holmesrichards/8StepSequencer/Docs/lmnc_8_step_seq.pdf

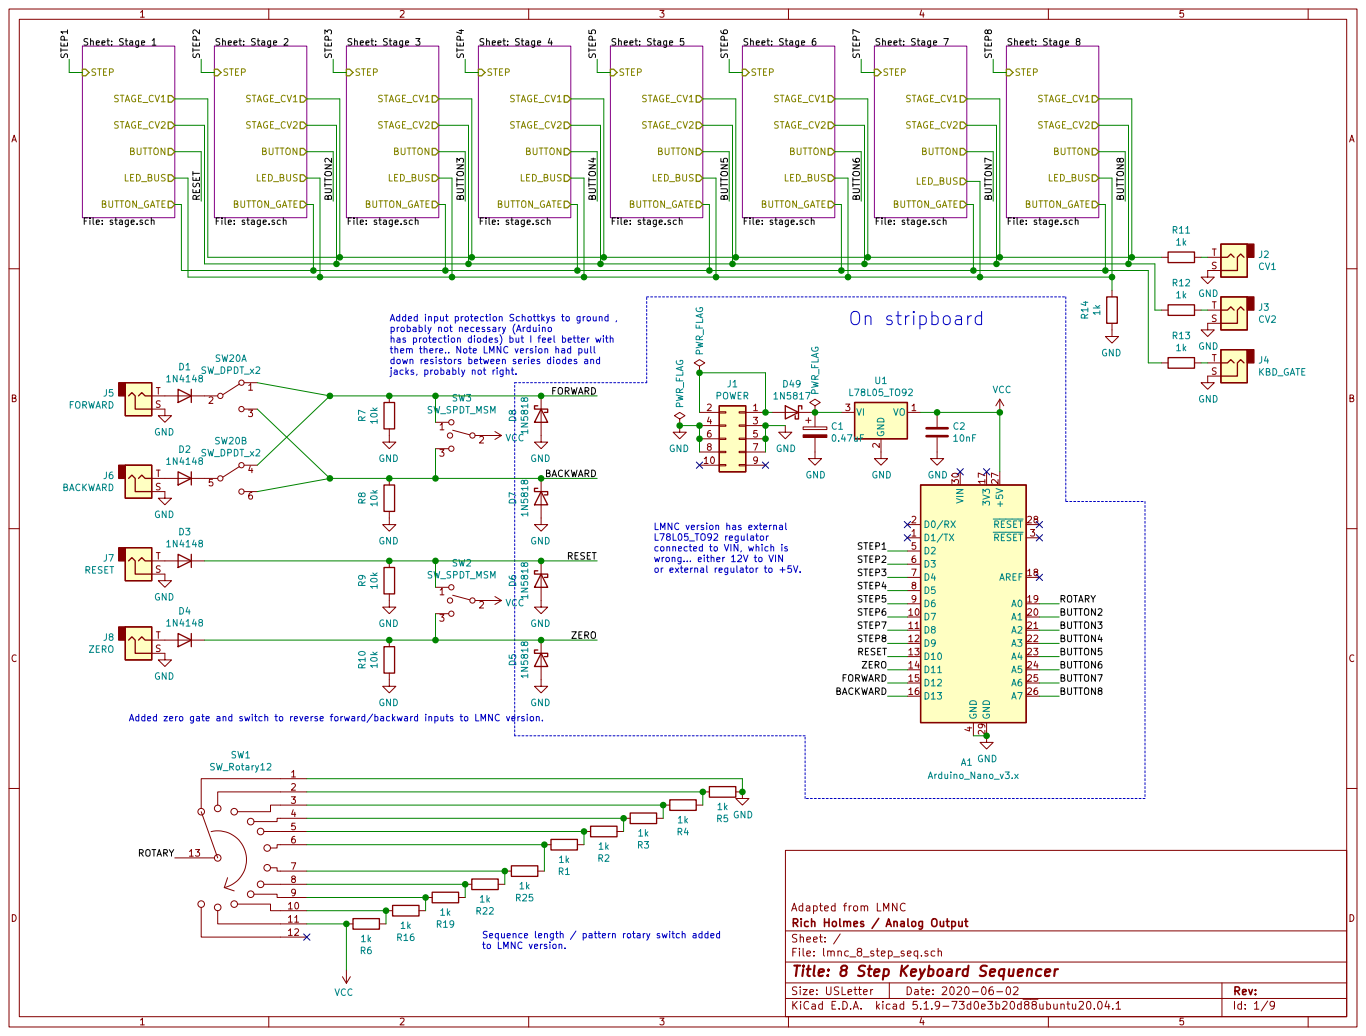
[picture p1: page 1]

File: stage.sch STAGE_CV1 STAGE_CV2 STEP

Added input protection Schottkys to ground ,
probably not necessary (Arduino
has protection diodes) but I feel better with
them there.. Note LMNC version had pull down resistors between series diodes and

jacks, probably not right.

GND GND

STEP8 STEP2 STEP7 STEP6 Sequence length / pattern rotary switch added

or external regulator to +5V.

Adapted from LMNC
File: lmnc_8_step_seq.sch Sheet: / Rich Holmes / Analog Output

Id: 1/9 Title: 8 Step Keyboard Sequencer

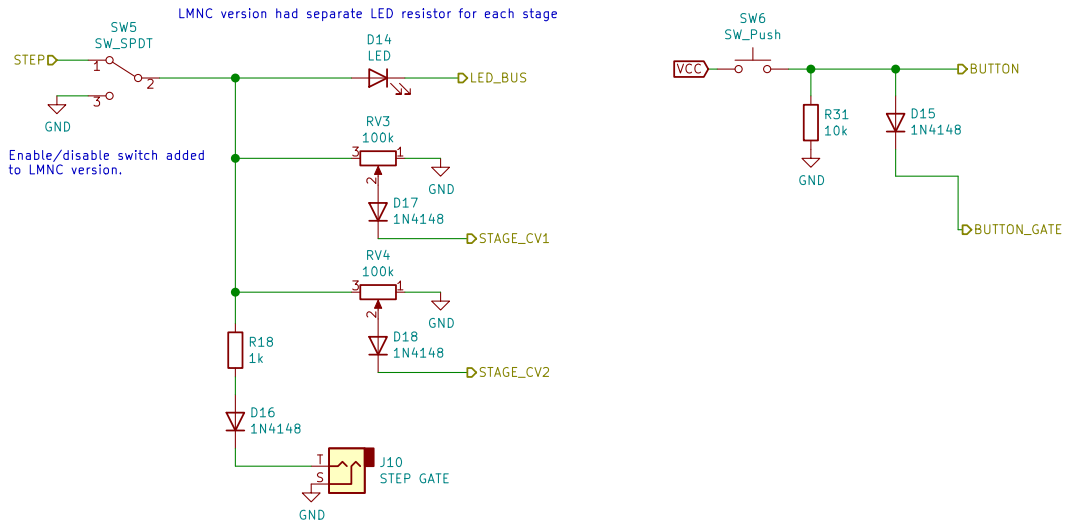
[picture p2: page 2]

LMNC version had separate LED resistor for each stage Enable/disable switch added

Adapted from LMNC
Rich Holmes / Analog Output
Sheet: /Stage 2/
File: stage.sch
Id: 2/9 Title: 8 Step Keyboard Sequencer

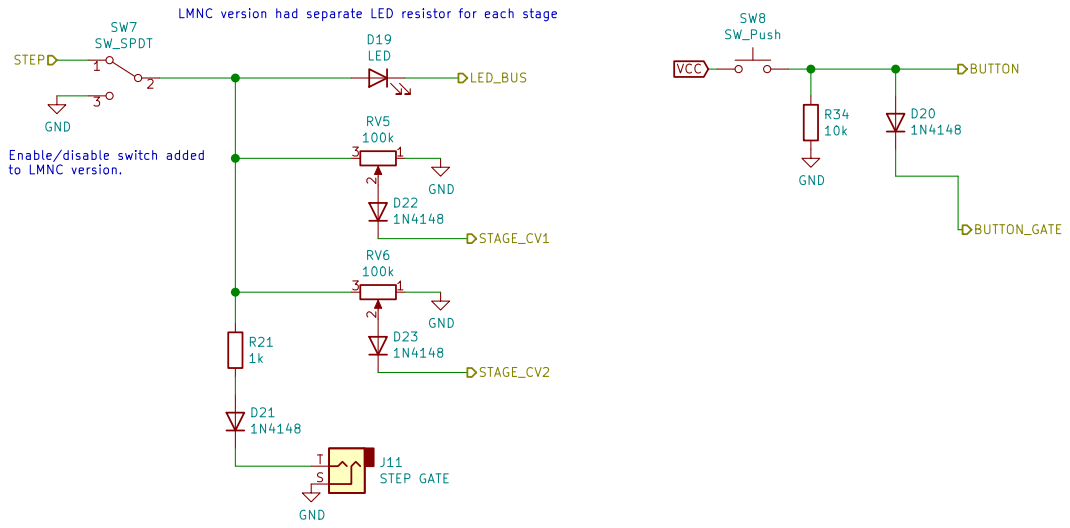
[picture p3: page 3]

LMNC version had separate LED resistor for each stage Enable/disable switch added

Adapted from LMNC
Rich Holmes / Analog Output
Sheet: /Stage 3/
File: stage.sch
Id: 3/9 Title: 8 Step Keyboard Sequencer

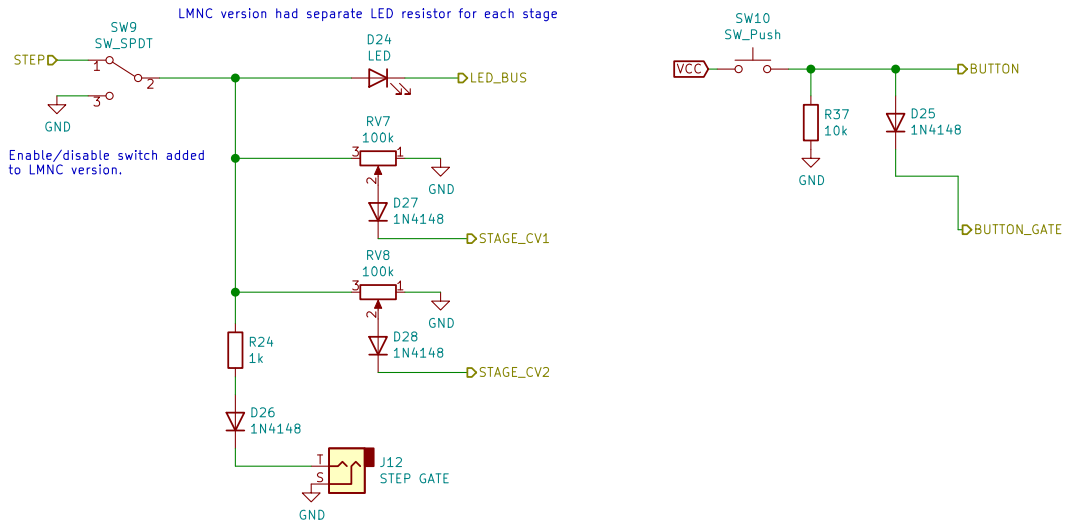
[picture p4: page 4]

LMNC version had separate LED resistor for each stage Enable/disable switch added

Adapted from LMNC
Rich Holmes / Analog Output
Sheet: /Stage 8/
File: stage.sch
Id: 4/9 Title: 8 Step Keyboard Sequencer

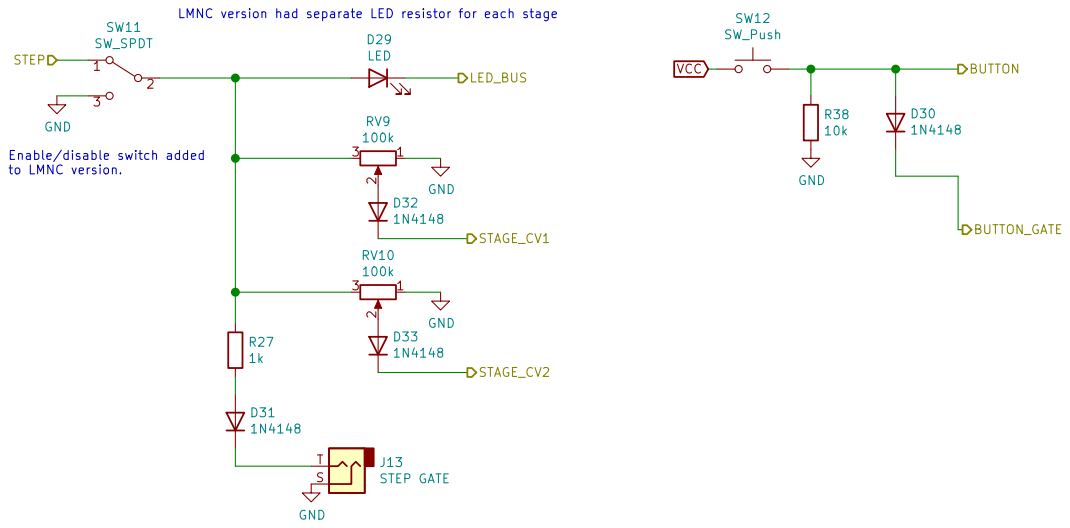
[picture p5: page 5]

LMNC version had separate LED resistor for each stage Enable/disable switch added

Adapted from LMNC
Rich Holmes / Analog Output
Sheet: /Stage 4/
File: stage.sch
Id: 5/9 Title: 8 Step Keyboard Sequencer

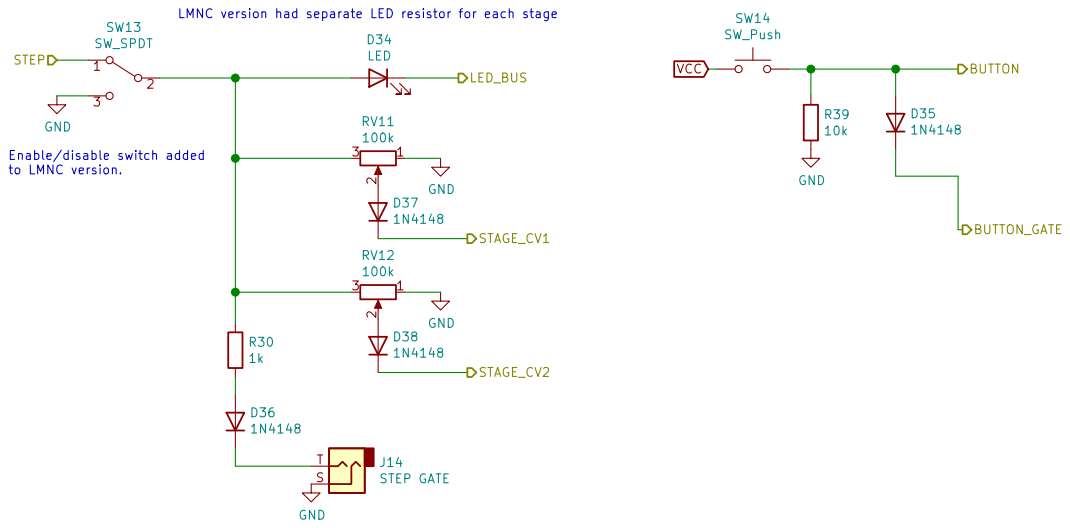
[picture p6: page 6]

LMNC version had separate LED resistor for each stage Enable/disable switch added

Adapted from LMNC
Rich Holmes / Analog Output
Sheet: /Stage 5/
File: stage.sch
Id: 6/9 Title: 8 Step Keyboard Sequencer

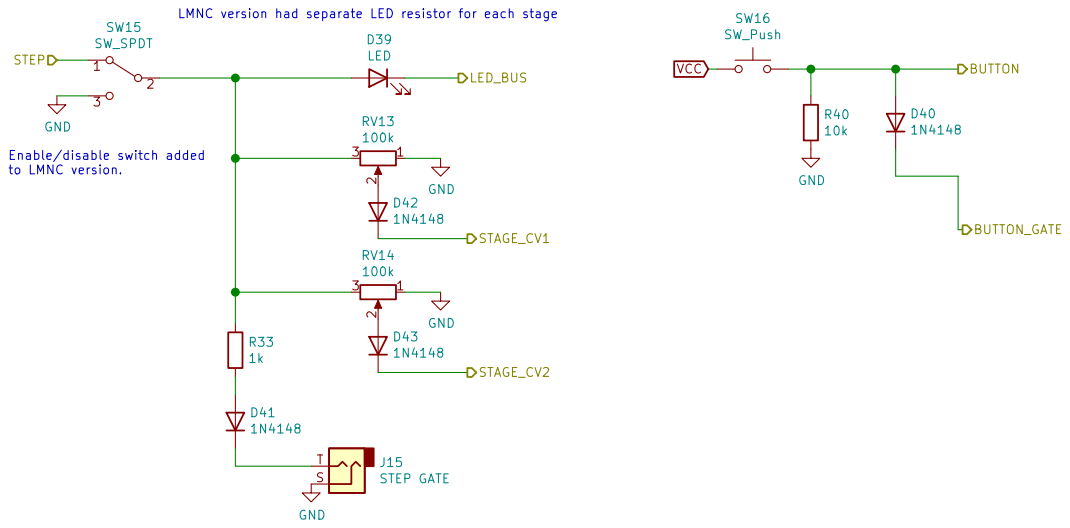
[picture p7: page 7]

LMNC version had separate LED resistor for each stage Enable/disable switch added

Adapted from LMNC
Rich Holmes / Analog Output
Sheet: /Stage 6/
File: stage.sch
Id: 7/9 Title: 8 Step Keyboard Sequencer

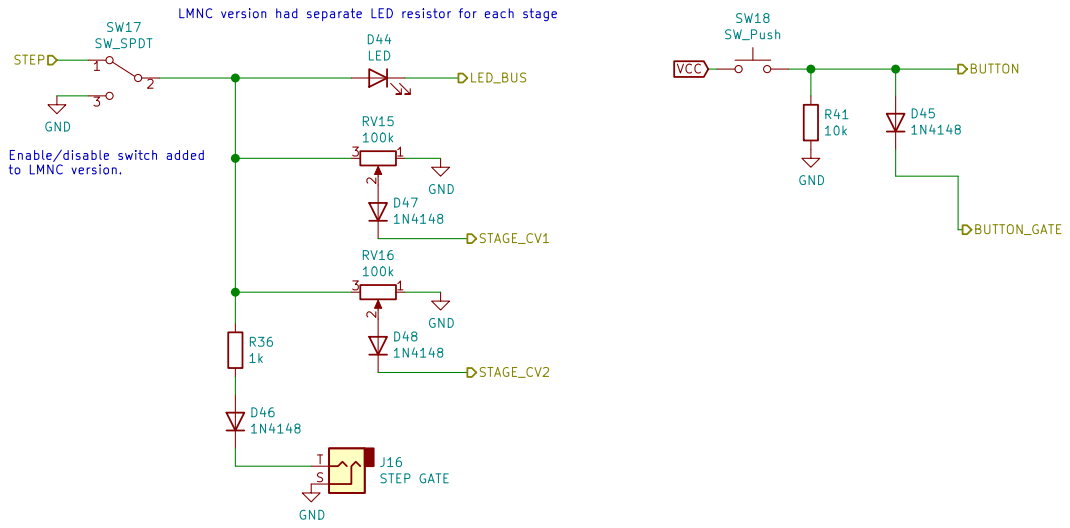
[picture p8: page 8]

LMNC version had separate LED resistor for each stage Enable/disable switch added

Adapted from LMNC
Rich Holmes / Analog Output
Sheet: /Stage 7/
File: stage.sch
Id: 8/9 Title: 8 Step Keyboard Sequencer

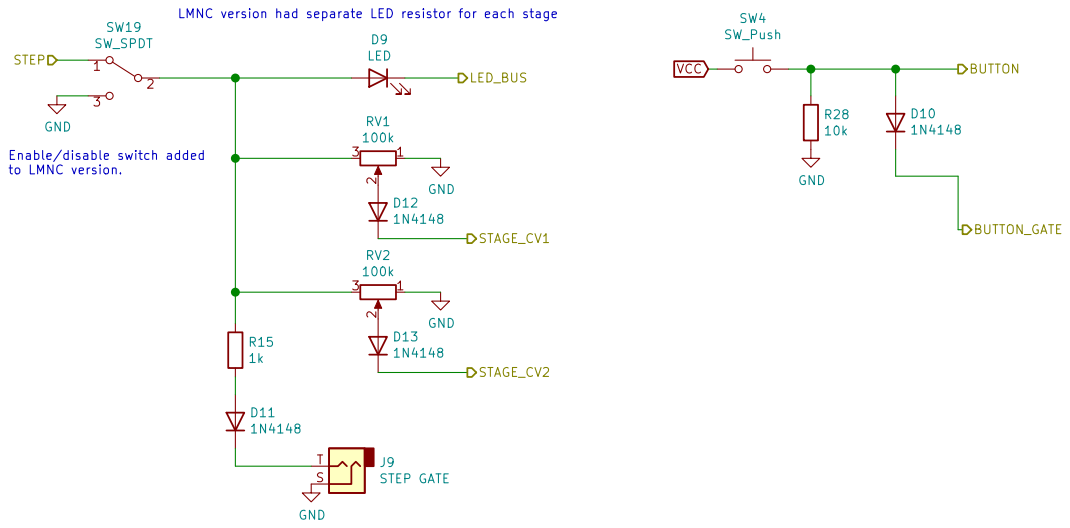
[picture p9: page 9]

LMNC version had separate LED resistor for each stage Enable/disable switch added

Adapted from LMNC
Rich Holmes / Analog Output
Sheet: /Stage 1/
File: stage.sch
Id: 9/9 Title: 8 Step Keyboard Sequencer
