holmesrichards/8StepSequencer/Hardware/lmnc_8_step_seq/lmnc_8_step_seq.kicad_pcb

## KiCad design Docs/Hw/LCD_tlacitka.sch

Schematic: LCD_tlacitka.sch

Parts:
D1: PWR
DS1: LCD??; WC1602A
J1: AVR-ISP-6
Q1: 9013
R1: 680R
R2: 3k
R3: 330
R4: 620
R5: 1k
R6: 3k3
R7: 4k7
RP1: 10K
SW1: RIGHT
SW2: UP
SW3: DOWN
SW4: LEFT
SW5: SELECT
SW6: RST

Notes on the sheet:
LCD
ICSP connector
Buttons
