holmesrichards/8StepSequencer/Hardware/lmnc_8_step_seq/lmnc_8_step_seq.kicad_pcb

## KiCad design Docs/Hw/led_7segment_.sch

Schematic: led_7segment_.sch

Parts:
AFF1: 3641BH
C1, C2, C3: 100n
C5: 47u
D1, D2, D3, D4: LED
J1, J2: Jumper
J3, J4, J5, J6: CONN_01X03
J7: APC220 Bluetooth
LS1-3: Buzzer
Q1: 3906
R1, R2, R3, R4: 1k
R5, R6, R7, R8: 10k
R9: 4k7
SW1: S1-A1
SW2: S2-A2
SW3: S3-A3
SW4: RESET
U2, U3: 74HC595
U4-IR-2, U5-18b20-LM35-A4: CONN_01X03
VR-A0: 10k

Notes on the sheet:
Buttons
LEDs
Seven-segment display
Headers
External module pin header
Multi-turn trimmer
Buzzer
Digital sensor
Analog sensor
