holmesrichards/8StepSequencer/Hardware/lmnc_8_step_seq/lmnc_8_step_seq.kicad_pcb

## KiCad design Docs/Hw/mcu_modul.sch

Schematic: mcu_modul.sch

Parts:
C1, C6, C7, C12: 100n
C2, C4: 22p
C3, C5: 47u
C8, C9, C11: C
C10, C13: 15p
D1: ON
D2: M7
D3: RX
D4: TX
D5: 1N4148?
D6: L
F1: Polyfuse
J1: USB_OTG
J2: BARREL_JACK
J3: AVR-ISP-6
J4: POWER
J5, J7: DIGITAL (~~PWM)
J6: ANALOG IN
Q1: Q_PMOS_GSD
R1, R2, R8: 10k
R3, R4, R5, R6, R7, R9: 1k
SW1: RESET
U1: LM358
U2: LM1117-5.0
U3: CH340G; SOP-16
U4: XC6206
U5: ATMEGA328P-AU; TQFP32
Y1: 12MHz
Y2: 16MHz

Notes on the sheet:
ICSP connector
LED
MCU
Power part
USB/UART
Pin headers
