holmesrichards/8StepSequencer/Docs/lmnc_8step_strip.png

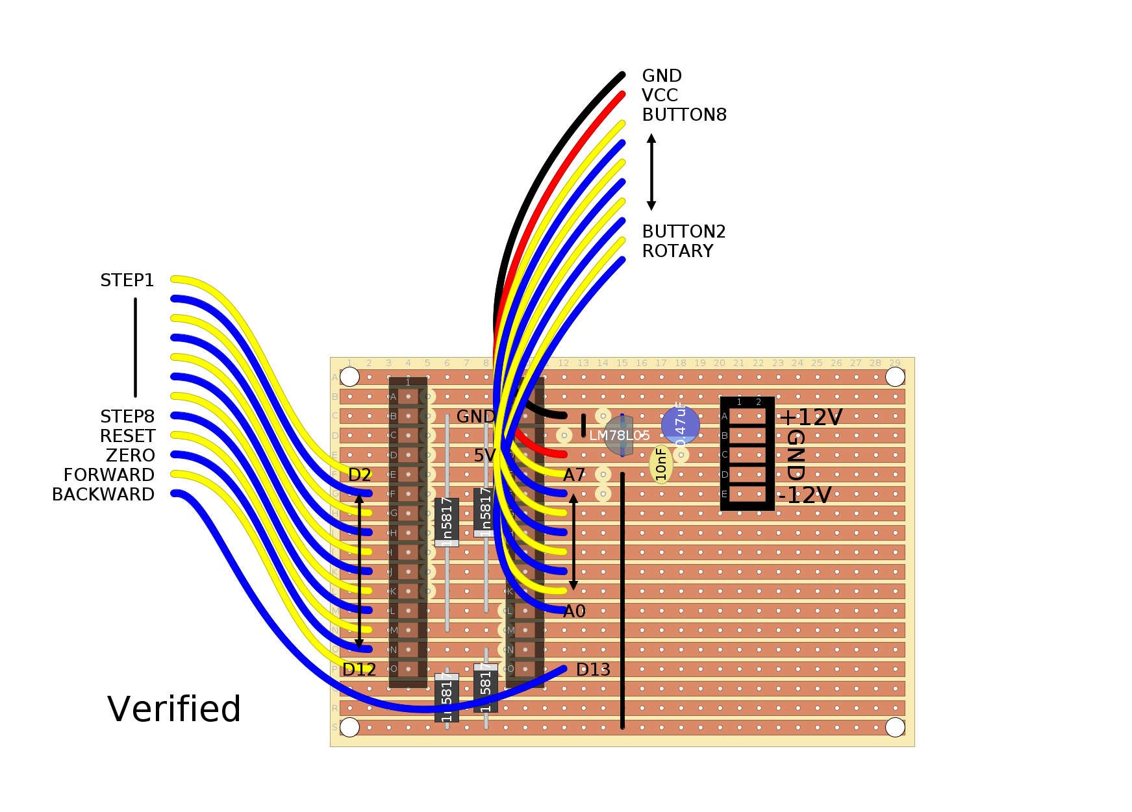
Docs/lmnc_8step_strip.png
