holmesrichards/8StepSequencer/(commit log)

2020-04-05 Initial version
    [lmnc_8_step_seq.kicad_pcb, lmnc_8_step_seq.sch, stage.sch]
2020-04-05 Add 5 new rotary switch positions for CTorp's patterns
    [lmnc_8_step_seq.sch]
2020-04-05 Reset pattern parameters on pattern change
    [sequencer.ino]
2020-04-05 Document new rotary switch functions
2020-04-05 Use all positions of rotary switch
2020-04-06 Use only 11 switch positions, 12 is redundant
    [lmnc_8_step_seq.sch]
2020-04-06 Fix numbering in comment
    [sequencer.ino]
2020-06-04 Single LED resistor; SPDT disable switch to connect to ground
    [lmnc_8_step_seq.sch, stage.sch]
2020-07-01 Some schematic tweaks; rearrange analog pins to put ROTARY on A7
    [lmnc_8_step_seq.sch, stage.sch]
2020-07-02 Reorganize folders
    [lmnc_8_step_seq.kicad_pcb, lmnc_8_step_seq.sch, stage.sch]
2020-07-03 Debugging, and adding switch debounce
2020-10-12 Correct pot orientation
    [stage.sch]
2021-01-08 Specify pot values
    [stage.sch]
2021-02-12 Make schematic consistent with code and stripboard, and fix errors in README
    [lmnc_8_step_seq.sch]
2021-02-17 Another attempt to get the pin order right
    [lmnc_8_step_seq.sch]
2021-02-23 Schottky comment in sch changed
    [lmnc_8_step_seq.sch]
2021-02-23 Make pin rearrangement easier, and add multiple button action
2021-02-23 Update docs; typo fix in software
    [sequencer.ino]
